algofoogle/ttihp26b-analog-junk/art/lily-and-duck.png

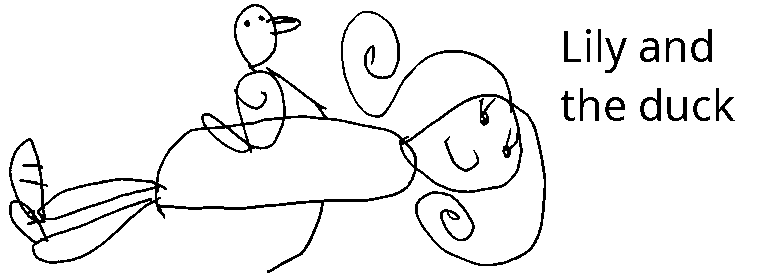
art/lily-and-duck.png
