algofoogle/ttihp26b-analog-junk/magic/r2r_dac.sim.spice

* NGSPICE file created from r2r_dac_pex.ext - technology: ihp-sg13g2

.subckt r2r_dac_pex IN[0] IN[1] IN[2] IN[3] IN[4] IN[5] IN[6] IN[7] VGND OUT
X0 R0b.R1 R1c.R2 VGND.t29 rhigh l=14.3u w=2u
X1 VGND.t21 VGND.t22 VGND.t20 rhigh l=14.3u w=2u
X2 R4b.R1 IN[4] VGND.t19 rhigh l=14.3u w=2u
X3 OUT R7b.R2 VGND.t10 rhigh l=14.3u w=2u
X4 IN[7] R7b.R2 VGND.t26 rhigh l=14.3u w=2u
X5 OUT R7c.R2 VGND.t17 rhigh l=14.3u w=2u
X6 R0d.R1 VGND.t2 VGND.t4 rhigh l=14.3u w=2u
X7 R4c.R1 R5c.R2 VGND.t13 rhigh l=14.3u w=2u
X8 R6b.R1 IN[6] VGND.t25 rhigh l=14.3u w=2u
X9 VGND.t1 VGND.t2 VGND.t0 rhigh l=14.3u w=2u
X10 R6b.R1 R7c.R2 VGND.t23 rhigh l=14.3u w=2u
X11 R4c.R1 R3c.R2 VGND.t8 rhigh l=14.3u w=2u
X12 R6c.R1 R7c.R2 VGND.t11 rhigh l=14.3u w=2u
X13 IN[5] R5b.R2 VGND.t15 rhigh l=14.3u w=2u
X14 R2b.R1 R3c.R2 VGND.t6 rhigh l=14.3u w=2u
X15 R6c.R1 R5b.R2 VGND.t16 rhigh l=14.3u w=2u
X16 R6c.R1 R5c.R2 VGND.t28 rhigh l=14.3u w=2u
X17 R2c.R1 R1b.R2 VGND.t24 rhigh l=14.3u w=2u
X18 IN[1] R1b.R2 VGND.t7 rhigh l=14.3u w=2u
X19 R2c.R1 R1c.R2 VGND.t5 rhigh l=14.3u w=2u
X20 R4b.R1 R5c.R2 VGND.t9 rhigh l=14.3u w=2u
X21 R0b.R1 IN[0] VGND.t3 rhigh l=14.3u w=2u
X22 R4c.R1 R3b.R2 VGND.t14 rhigh l=14.3u w=2u
X23 IN[3] R3b.R2 VGND.t18 rhigh l=14.3u w=2u
X24 R0d.R1 R1c.R2 VGND.t27 rhigh l=14.3u w=2u
X25 R2b.R1 IN[2] VGND.t12 rhigh l=14.3u w=2u
X26 R2c.R1 R3c.R2 VGND.t30 rhigh l=14.3u w=2u
R0 VGND.t0 VGND.t4 457.767
R1 VGND.t4 VGND.t27 457.767
R2 VGND.t27 VGND.t29 457.767
R3 VGND.t29 VGND.t3 457.767
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
C191 R2b.R1 VGND 4.10265f
C192 R3c.R2 VGND 6.31496f
C193 R1b.R2 VGND 4.10346f
C194 R2c.R1 VGND 6.31345f
C195 R0b.R1 VGND 4.10259f
C196 R1c.R2 VGND 6.33938f
C197 R0d.R1 VGND 4.24005f
C198 VGND.t2 VGND 3.79434f
C199 VGND.t21 VGND 2.06777f
C200 VGND.t1 VGND 2.06591f
C201 VGND.t22 VGND 2.06777f
.ends
