algofoogle/ttihp26b-analog-junk/(commit log)

2026-09-18 Trivial inverter example
    [inverter.sch, tb_inverter.sch]
2026-09-18 1st rough attempt at comparator schematic
    [comparator.sch, tb_comparator.sch]
2026-09-21 First comparator schematic
    * Basic comparator: 5T OTA + 2T amp + inverter
    * TB with PFET current source for tail Vbias
    [comparator.sch, tb_comparator.sch]
2026-09-21 Comparator layout, passing LVS
    [comparator.sch, tb_comparator.sch]
2026-09-21 Minor changes
    [tb_comparator.sch]
2026-09-21 Vbias and R2R DAC cells
    * Dedicated Vbias circuit & layout
    * R2R DAC adapted from my ttihp0p3-antonalog design
    * Custom LVS setup to remove mm_ok property
    * Minor fixes to ohter things
    [r2r_dac.sch, tb_comparator.sch, tb_r2r_dac.sch, vbias.sch]
2026-09-21 Minor tidyup
    [r2r_dac.sch]
2026-09-23 Starting TB using ADC model as an input driver
2026-09-24 Update docs. Add TT mux and2_2 driver to PEX SPICE sim
    [r2r_dac.sch]
